iamnedtan/NSAS/systems/README.md

# Created systems

Accessories and sets built on NSAS, grouped by hobby or use. Each system has its own folder and README.

| System | Contents |
|---|---|
| [modelling-gunpla](modelling-gunpla/) | Tool holders for plastic model building: nipper holder, sanding block |
| [tools](tools/) | Everyday desk tools and supplies: mini coffee cup holder (Starbucks, Luckin) |
| [nabs](nabs/) | NABS, Ned Angle Base System: hinged base plates with NSAS sockets, slot-ins, joiners and an NSAS panel adapter. Own spec, draft v0.1 |

Planned: display garages built on NABS, and other systems.
