iamnedtan/NSAS/spec/NSAS Spec Sheet.html

Specification

# Ned Slotted Angle System

45° gravity-lock socket grid for FDM-printed panels and accessories

DocumentNSAS-SPEC

Revisionv0.13 draft

Date2026-10-21

Unitsmm, degrees

Viewsto scale, per view

ProcessFDM

## 壱What it is 概要

A pegboard-style mounting surface. A grid of 5 mm square sockets is cut into a panel. Every socket slopes 45° downward into the material. Accessories such as trays and tool holders carry matching holes, and a square key joins the accessory to a socket. The key is one straight bar, so the accessory hole lies on the same 45° line as the socket but, seen from the accessory's back face, it rises as it goes in (section 7).

The socket slopes down as it goes in, so the accessory's weight pushes the key deeper. The key cannot be pulled straight out. To remove it, lift and tilt. No clips or screws are needed.

An optional thin groove between socket rows hollows out the panel and stiffens it for FDM printing.

## 弐Orientation and terms 向きと用語

Term | Meaning
Face | Panel surface the accessories hang on. Used vertically.
Back face | Flat accessory surface that rests against the panel face. Accessory holes start here.
Perpendicular (⊥) | Measured at right angles to the face, into the panel. All depths are perpendicular.
Vertical | Measured up and down along the face.
Along the slope (∥) | Measured along the 45° socket axis. Equals perpendicular × √2.
Cross-section | Square sizes (socket 5.00, key 4.60 / 4.80 / 5.00 / 5.10) are measured across the 45° axis, at right angles to it.
C–C | Centre to centre. All pitches and hole spacings are C–C.
Face height | A 45° feature that is t thick across its walls shows t × √2 tall on the face. A 5.00 socket shows 7.07.

## 参Socket ソケット

View A. Section through one socket. Face on the left, hatched material, 1 mm skin at the back.

Item | Value
Cross-section | 5.00 × 5.00 square (across the axis)
Angle | 45° down into face
Face height | 7.07 (5 × √2)
Functional depth | 10.00 ⊥ (14.14 along slope)
Modelled depth | 11.00 ⊥ (15.56 along slope)
Floor | Flat, parallel to face
Mouth lead-in | 0.5 × 45° chamfer on side edges, 22.5° bevel on lip (not drawn)
Min. panel thickness | modelled depth + skin (11 + 1 = 12)

- Modelled depth = functional depth + 1 mm. The relief keeps the key off the floor.
- Surface too thin: add a local raised panel, or use a shallower face with a customised key (section 6).

## 肆Grid layout グリッド配置

The grid has no fixed size. Fit as many columns and rows as the area allows, then centre the grid so that opposite margins are equal. Rows are not staggered.

Tileable panels. When panels may be combined side by side or stacked, use a 2.50 margin left and right and a 5.732 margin top and bottom. Two margins then add up to exactly one wall (5.00) or one row gap (11.464), so the column pitch, row pitch and the 30 mm rule carry on across the joint. Panel size: n columns × 10.00 wide, r rows × 18.536 tall.

View B. Face view, example 5 columns × 3 rows with grooves. Sockets solid, grooves grey. m = equal margins.

View C. Section through three rows. Vertical dimensions on the face.

### Columns

Item | Value
Column pitch | 10.00
Wall between sockets | 5.00
Outer-wall span, n columns | (n − 1) × 10 + 5
Side margin, tileable | 2.50 (wall / 2)
Panel width, tileable | n × 10

### Rows: the 30 mm rule

Top wall of row k to bottom wall of row k + 2, measured vertically, is 30.000. With h = 7.071 face height:

Item | Formula | Value
Row pitch | (30 + h) / 2 | 18.536
Gap | (30 − h) / 2 | 11.464
Outer to outer, 2 rows | (30 + 3h) / 2 | 25.607
Row k → k + 2 | 2p − h | 30.000
Solid between tunnels ⊥ | p × sin 45° − 5 | 8.107
Top / bottom margin, tileable | gap / 2 = (30 − h) / 4 | 5.732
Panel height, tileable, r rows | r × p | r × 18.536

Stacked tileable panels: the row gap at the joint is split across the two panels, so it gets no groove.

## 伍Groove 溝 optional

- Purpose: hollows out material and increases strength for FDM printing. Less infill is needed, but the extra walls can make the print take longer.
- Include: ask if the groove is required.
- Skip: when the area is small and does not need it, for example a small accessory panel or a single row. Say that it was skipped.
- Wide top-edge groove (reference cover, optional): same purpose. It reinforces the panel for FDM printing and reduces infill, at the cost of a possibly longer print. Take its profile from the reference cover; it is not dimensioned here.

Item | Value | Notes
Position | One in every gap between rows | Views B and C
Vertical placement | Centred in the gap | 4.25 land above and below
Thickness | 2.10 ⊥ walls | 2.97 on the face
Angle | 45° down | Parallel to the sockets
Depth | 8.00 ⊥
Wall to each socket | 3.00 ⊥ walls | (8.107 − 2.10) / 2; constant along the groove
Material behind floor | 4.00 | On a 12 mm panel (12 − 8)
Length | Equal to the outer-wall span | (n − 1) × 10 + 5
Ends | Square, aligned with the outermost socket walls

## 陸Key キー

The key joins the accessory to the panel sockets. It is one straight 45° square bar with a thin stop plate across it. The bar fits snugly into the panel (not a press fit), so accessories can be moved and replaced quickly. It press-fits into the accessory, so it stays with the accessory when moved. The stop rests flat on the panel face and sets the insertion depth.

The two side faces are flat and flush along the whole key (4.60 apart), so it prints lying on one side. Both legs share one profile: a split peg whose upper and lower faces widen in a straight line from the root to a square tip, with a 1.00 slot along the axis that splits it into two prongs. Neither leg has a chamfer, lead-in or root relief (v0.13). Instead, every edge that runs across the key between the flat sides has a 0.50 round: the tips, slot mouths, slot ends and stop ends. The four inside corners where the stop meets the legs stay sharp, so the stop seats flat. The legs differ only in fit. The accessory leg is an expanding peg: it is 5.80 long, 0.20 short of the 6.00 hole floor, and widens from 4.80 at the root to an oversize 5.10 at the tip, so in the 5.00 hole the prongs squeeze together and spring back against the walls. The panel leg has a lighter fit: it widens from 4.60 to 5.00 (line-to-line), and its slot stops 3.00 from the panel face. The accessory slot runs back toward the stop until its end is 5.00 from the panel slot end, measured along the bar, so it ends 0.46 inside the stop (View D1). Neither leg has crush ribs (v0.11): both keep 0.20 side clearance per side.

View D. Key seated in a panel socket and an accessory wall. Key shaded; prongs drawn relaxed (before they squeeze to 5.00), slot between them. Square tips with the 0.50 edge rounds on the tips, slot mouths, slot ends and stop ends. The leg tip stops 0.20 short of the hole floor.

Item | Value | Fit
Panel leg, root | 4.60 × 4.60 | 0.20 / side clearance
Panel leg, tip | 5.00 × 4.60 | Snug, line-to-line; taper on upper and lower faces
Panel prong slot | 1.00 wide, to 3.00 ⊥ from panel face | Solid near the face for bending strength
Panel leg tip end | square | No chamfer; 0.50 edge rounds
Panel leg engagement | 10.00 ⊥ from panel face | Stop on face; 1.00 relief to floor
Side faces, whole key | 4.60 apart | Flat and flush; 0.20 / side clearance; print on either side
Accessory leg, root | 4.80 × 4.60 | 0.10 / side clearance in 5.00 hole
Accessory leg, tip (relaxed) | 5.10 × 4.60 | 0.05 / side interference, taken by the prongs; square tip, 0.50 edge rounds
Accessory leg taper | linear, 4.80 → 5.10 | Upper and lower faces only, widens to the tip; line-to-line at 3.87 ⊥ from the stop (2/3 of the length)
Prong slot | 1.00 wide; end 5.00 from the panel slot end, along the bar | Ends 0.46 ⊥ inside the stop; deepest point 0.39 ⊥ from the panel face (View D1). Through both side faces; keep wider than tip − hole
Accessory leg length | 5.80 ⊥ | From stop to tip; 0.20 tip gap to the 6.00 hole floor
Edge rounds | 0.50 | Every edge running between the flat sides: leg tips, slot mouths, slot ends (full round), stop ends. Not on the four stop-to-leg inside corners
Stop | 1.00 ⊥ × 4.60 × 12.00 | Vertical plate, flat on panel face; ends cut at 45°; 2.75 past the bar above and below
Accessory hole | 5.00 square, 6.00 ⊥, rising | Fit set by the key only; see section 7

View D1. The two prong slot ends at the stop. Both ends are full rounds (0.50 radius). Measured along the bar, from the end of one round to the end of the other, they are 5.00 apart (3.54 ⊥). The panel slot end does not move, so the accessory slot ends 0.46 ⊥ inside the 1.00 stop. The stop stays solid on the panel face and above and below the slot.

View E. Key sections (shaded) inside a 5.00 hole (dashed). Tapered faces top and bottom, flat sides left and right. All three sections are split: the accessory slot reaches past the leg root into the stop. No crush ribs; 0.20 side clearance per side.

- Shallow faces: shorten the panel leg to that face's functional depth. Keep the 1 mm relief.
- Print orientation: lie the key on either flat side. The slot walls are then vertical, and each prong flexes within its layers.
- Tuning: loose: raise the tip (5.10 → 5.20). Too hard to push in: lower the tip or widen the slot. Keep the slot wider than tip − hole, so the prongs never close up.
- Stop check: the accessory slot ends inside the stop, so the stop is thin at the slot end (0.39 at the deepest point). After a few insert-and-remove cycles, look for cracks there. If it cracks, increase the slot spacing or thicken the stop.
- Fit check: before a full accessory, print one key and a small block with one 5.00 hole. Adjust the tip size, then keep the values that work for your printer.
- Tip gap: keep the accessory leg 0.20 shorter than the hole depth. Zero gap fitted best in test, but then a hole printed slightly shallow stops the key before the stop seats.

### Variant: thick stop

For accessories that must stand farther off the panel face, for example to clear obstructions such as the lip of a cover design. The stop is 3.00 thick instead of 1.00. The extra 2.00 grows toward the panel side: everything from the stop's accessory face outward is the same as the standard key, and the panel leg still engages the full 10.00 from the panel face. The accessory back face therefore sits 3.00 from the panel face (1.00 on the standard key).

Item | Standard | Thick stop
Stop thickness ⊥ | 1.00 | 3.00
Stop width × height | 4.60 × 12.00 | 4.60 × 12.00 (unchanged)
Panel leg, accessory leg | 10.00, 5.80 | 10.00, 5.80 (unchanged)
Accessory slot end | 0.46 ⊥ inside the stop | 0.46 ⊥ inside the stop, from its accessory face
Slot ends apart, along the bar | 5.00 | 7.83 (5.54 ⊥)
Panel face to accessory back face | 1.00 | 3.00
Overall length ⊥, tip to tip | 16.80 | 18.80
Edge rounds | 0.50 | 0.50, same edges

- Model: keys/NSAS key - accessories thick. Same parameters as the standard key with stop_t = 3 mm. The accessory slot end is held at its standard place: prong_root uses the standard 1 mm stop, not stop_t.
- Accessories and panels are unchanged: same sockets, same 6.00 accessory holes. Only the stand-off grows.
- Stop check: not needed on this variant. The stop is solid for 2.39 ⊥ behind the slot end.

## 漆Accessory interface アクセサリー接続部

Holes go in the accessory's back face, the flat face that rests against the panel. The key's stop sits between the two faces.

Direction — common mistakeThe key is one straight bar. Its panel leg goes into the panel and down, so its accessory leg points out of the panel and up. The accessory hole follows that leg: from the back face it goes in and rises 45°, 1 mm up for every 1 mm in. Same 45° line as the socket, run the other way. Never copy the socket's "45° down into the face" onto the accessory: a downward hole cannot take a key that is already in the panel. See View D.

Gravity lock: the accessory is pressed onto the rising leg, and its weight pulls it down and back along the bar, toward the panel.

Item | Value | Notes
Cross-section | 5.00 × 5.00 square | 0.10 / side over the 4.80 key root; fit set by the key taper
Direction | 45° rising into the accessory | Same line as the socket, opposite sense
Face height | 7.07 | 5 × √2, on the back face
Depth | 6.00 ⊥ (8.49 along slope) | Accessory leg 5.80 + 0.20 tip gap
Floor | Flat, parallel to the back face | 6.00 higher than the mouth
Blind or through | Blind when the wall is thicker than depth + skin | Through only on a wall thinner than the depth; the leg still needs its full 5.80

### Placement

- Horizontal hole spacing, C–C: a multiple of 10.00. Reference tray: 2 holes, 40 apart.
- Vertical hole spacing, C–C: a multiple of 18.536.
- Width for side-by-side hanging: n columns wide = n × 10 − clearance. Suggested clearance 1.00 total, so a 2-column holder is 19.00 wide.
- Top margin: the floor ends one depth higher than the mouth. Top of the back face to top of the upper mouth ≥ depth + skin (6 + 2 = 8.00).
- Wall behind the floor: check cavities, slopes and fillets inside the accessory. Keep at least 2.00 skin.
- Check before finishing: from the back face, every hole goes in and up. A key already in a panel socket must slide straight into it.

## 捌Parameters パラメーター

Drive the model from these values. Derive counts, row pitch and groove length; do not enter them as fixed numbers. Keep full precision in CAD; round only the displayed values.

Parameter | Default | Drives
Functional depth | 10.0 | Key engagement, modelled depth
Relief | 1.0 | Modelled depth = functional + relief
Socket size | 5.0 | Socket section, face height, accessory hole
Column pitch | 10.0 | Column count, span
Row rule distance | 30.0 | Row pitch, gap, row count
Groove thickness / depth | 2.1 / 8.0 | Groove section
Key root / tip width | 4.8 / 5.1 | Accessory leg taper; tip oversize for the expanding fit
Prong slot width / slot spacing | 1.0 / 5.0 | Prong flex; slot spacing is the distance between the accessory and panel slot ends, along the bar. The accessory slot end follows from it.
Accessory leg tip gap | 0.2 | Accessory leg = hole depth − tip gap (5.8)
Edge round | 0.5 | Edges between the flat sides: tips, slot mouths, slot ends, stop ends
Panel leg tip width / slot root land | 5.0 / 3.0 | Panel snug fit; solid leg next to the panel face
Key stop thickness / height | 1.0 / 12.0 | Stop plate; sets key insertion depth
Accessory hole depth | 6.0 | Key accessory leg + tip gap; floor height above the mouth
Accessory top skin | 2.0 | Top margin = hole depth + skin
Accessory width clearance | 1.0 | Width = columns × 10 − clearance
Panel area or margins | per design | Counts and centring
Tileable margins, side / top and bottom | 2.5 / 5.732 | Panels combined side by side or stacked; 5.732 = (30 − h) / 4

## 玖Open points 未決事項

None at present. Earlier points closed in v0.13: wide top-edge groove purpose (section 5), grid margins for tileable panels (section 4).

## 拾Revisions 改訂履歴

Rev | Change
v0.1 | First draft from design intent and the reference top cover.
v0.2 | Groove made optional. Purpose: hollowing and FDM strength.
v0.3 | Key slips into the panel. Key customisable for shallow faces.
v0.4 | Accessory leg tapers 4.8 → 5.0 for a press fit.
v0.5 | Key shape fixed: one straight 45° bar with a 1 mm stop. Groove face height 2.97, land 4.25.
v0.6 | Added ∥ and C–C conventions, groove wall 3.00 and floor material 4.00, key engagement datum, fit check.
v0.7 | Accessory hole direction fixed: rises 45° into the accessory (was read as "same as the socket", i.e. downward). Added hole depth 6.00, floor, blind/through, top margin, wall skin, side-by-side width and a direction check. Back face term added.
v0.8 | Key side faces flat and flush along the whole key (4.60); taper on the upper and lower faces only.
v0.9 | Tapered press fit proved loose. Accessory leg is now an expanding peg: slot splits it into two prongs, tip oversize 5.30 (root 5.00), 0.60 tip lead-in, two crush ribs on one side face (0.15 crush). New parameters for slot, lead-in and ribs.
v0.10 | Panel leg: snug fit, widens 4.60 → 5.00, prong slot to 3.00 from the face, two crush ribs (0.05 crush) on the same side face, 1.00 chamfer on the upper tip edge. All crush ribs taper 0.15 lower toward the tip.
v0.11 | Stop height reduced, 15.0 → 12.00 (2.75 past the bar above and below). All crush ribs removed from both legs.
v0.12 | Accessory leg kept popping out. Taper 5.00 → 5.30 reduced to 4.90 → 5.10. Ø1.00 relief at the root on the upper and lower faces, tangent to the stop. Prong slot now ends 1.00 from the stop (was 0.50).

v0.13

Print-tested: fits very well. Accessory leg takes the panel leg profile: straight taper 4.80 → 5.10 (root was 4.90), square tip, root reliefs and tip lead-in removed. Accessory leg 5.00 → 5.80, 0.20 short of the 6.00 hole floor (was 1.00). Accessory prong slot made longer: its end is 5.00 from the panel slot end along the bar (was 7.07), so it ends 0.46 inside the stop. Panel tip chamfer removed. 0.50 round on every edge between the flat sides, except the stop-to-leg inside corners. Thick-stop variant (3.00 stop, grown toward the panel side) added. Tileable-panel margins 2.50 side, 5.732 top and bottom. Groove trade-off and wide top-edge groove purpose added. Open points closed.
