iamnedtan/NSAS/systems/nabs/spec/NABS Spec Sheet.html

Specification

# Ned Angle Base System

Hinged base plates with NSAS 45° sockets, for displays and storage. Builds on NSAS-SPEC v0.13.

DocumentNABS-SPEC

Revisionv0.1 draft

Date2026-10-23

Unitsmm, degrees

ReferencesNSAS-SPEC v0.13

ProcessFDM

## 壱What it is 概要

A modular base plate for displays and storage, first made for plastic models. Each base is a flat plate with two rows of 45° sockets in its top face. Slot-in parts (uprights, runner holders, adapters) stand in the sockets on plain square legs.

NABS takes the NSAS socket (5.00 square, 45°) and the NSAS pitches (10.00 columns, 18.536 rows) from the NSAS spec sheet, v0.13. It does not take the NSAS key: NABS slot-ins have plain legs (section 7).

- Hinge edges: both long edges carry interleaving fingers. Two bases pinned with a length of 1.75 mm filament lie flat side by side, or one folds up 90° to make a wall (vertical mode).
- Sides: the short edges have no fingers. Bases placed side to side are locked by a side joiner in the middle channel, and the socket rows carry on across the joint.
- NSAS panels: a stack angle adapter lets a base slot into an NSAS panel like an accessory.

Rules and as-modelled valuesValues with no mark are design rules. Values marked as modelled are read off the Fusion model and are not yet design rules. The drawings are cut from the Fusion export, to scale per view.

## 弐Orientation and terms 向きと用語

Term | Meaning
Floor mode | The base lies flat, top face (socket mouths) up. All values are given in floor mode.
Vertical mode | The base folded 90° about its hinge, standing as a wall.
Column | One 10.00 slice of the base along its length: one socket per row, one channel hole, one finger per hinge edge.
Length, L | Along the rows, side to side. L = n × 10.00 for n columns.
Across | At right angles to the rows, hinge edge to hinge edge. Given from body face A (0.000) toward edge B.
Sides | The two short edges, at the ends of the rows. No fingers.
Hinge edges | The two long edges, with fingers. Edge A: wide fingers (4.95). Edge B: narrow fingers (4.75). Every socket descends toward edge B.
Body face | The flat face of the plate at a hinge edge, from which the fingers stick out.
Height | From the bottom face (0.0).
⊥, ∥, cross-section, C–C | As NSAS: perpendicular to the face, along the 45° slope, across the 45° axis, centre to centre.

## 参Base plate ベースプレート

View A. Section across the base through one socket column (column 1, through an edge-A finger). Hatched material. The edge-B fingers lie between the edge-A fingers, so they are not in this cut.

Item | Value | Notes
Thickness | 10.0
Body across | 64.142 | body face A → body face B; 37.071 + 27.071
Overall across | 84.142 | fingers 10.0 past each body face
Length | n × 10.0 | n = columns, a parameter in the Fusion model
Reference model | n = 10, 100 × 84.142 × 10
Top edges | 1.0 × 45° | on the body faces; as modelled

- Columns are a parameter. Every feature that repeats per column (sockets, triangle marks, channel holes, hinge fingers) follows n. Top pockets and underside hollows split by the rule in section 5.

## 肆Sockets and rows ソケットと列

View B. Plan from above, n = 10, rows running left to right, edge A at the top. Socket mouths and channel holes solid, pockets and the middle channel grey, triangle marks outlined.

### Socket

Item | Value | Notes
Cross-section | 5.00 × 5.00 | as NSAS
Angle | 45°, descending toward edge B | as NSAS
Mouth across, on the top face | 7.071 | 5 × √2
Depth | through the 10.0 plate (14.14 ∥) | NSAS sockets are blind. NABS keeps them through: no floor to print, debris falls out.
Mouth lead-in | ≈ 0.7 × 45° on the side edges; 22.5° bevel, 1.0 wide, on the edge-B lip | as modelled; not drawn

### Columns

Item | Value | Notes
Column pitch | 10.00 | as NSAS
First socket centre from the side | 5.0 | side margin 2.50, the NSAS tileable margin: bases side to side keep the 10.00 pitch
Wall between sockets | 5.00

### Rows

Each base has two rows. They are NSAS rows k and k + 2: two row pitches apart, with no row between them.

Item | Value | Notes
Row 1 mouth, across | 10.000 → 17.071
Row 2 mouth, across | 47.071 → 54.142
Row pitch | 37.071 | 2 × 18.536, the NSAS row pitch
Between the mouths | 30.000 | 2 × 18.536 − 7.071: the original NSAS 30 mm rule (section 10)
Base pitch across, pinned flat | 74.142 | 2 × 37.071: rows carry on at 37.071 across the hinge

### Triangle marks

Item | Value | Notes
Shape | equilateral, 4.0 side, 0.6 deep | cut into the top face
Direction | points toward edge B | the way the sockets descend
Along | between every pair of adjacent sockets | n − 1 per row; design rule
Across | row 1: 4.000 → 7.464; row 2: 43.571 → 47.035 | as modelled

The marks show which way the sockets slope, and they are decoration.

## 伍Channel, pockets and hollows 中央溝と肉抜き

### Middle channel

Runs the full length between the two rows. It takes the side joiner, the stack angle adapter and the M3 screws.

Item | Value | Notes
Across | 33.071 → 41.071 (8.0 wide)
Floor | 5.0 thick | channel 5.0 deep
Top edges | 1.5 × 45° | from 8.5 to the top face
Holes | 8.0 × 5.0, through the floor | one per column, on the socket columns; 5.0 webs between

### Top pockets: split rule

One lightening pocket runs beside each row: on row 1 between the row and the channel, on row 2 between the row and body face B. Their walls follow the 45° slope; inner corners 1.0 round. Profile as modelled.

- Pockets per row = ⌈n / 5⌉: one pocket for up to 5 columns, a new pocket for each further 5 columns or part of 5.
- All pockets in a row are the same length, with a 4.0 rib between them and a 2.5 end margin at each side.
- Pocket length = (L − 5.0 − 4.0 × (k − 1)) / k, for k pockets.

Columns n | Pockets per row | Pocket length
4 | 1 | 35.0
7 | 2 | 30.5 (3.5 columns each)
10 | 2 | 45.5
12 | 3 | 35.67 (about 4 columns each)

### Underside hollows

Each row has a hollow open to the bottom face, on the edge-A side of the socket tunnel: 2.0 roof, 2.0 wall to the socket, parallel to the slope (View A). They split with the top pockets (2.0 rib at n = 10). Small 1 × 1 relief grooves run along the bottom face. All as modelled.

## 陸Hinge and sides ヒンジと側面

View C. Two bases pinned flat, plan cut at 7.5, above the pin. Pin hole dashed.

View C2. Section through an edge-A finger, with the Ø1.75 filament pin (shaded) in its Ø2.5 hole.

Item | Value | Notes
Finger length | 10.0 past the body face | both edges
Edge A fingers | 4.95 wide, at 0 → 4.95 in each column | from the side
Edge B fingers | 4.75 wide, at 5.15 → 9.90 in each column
Finger clearance | 0.20 and 0.25 | between interleaved fingers
Pin hole | Ø2.5, full length, 5.0 high | mid-thickness
Pin hole, across | mid-finger: 5.0 from the tip and from the body face | both edges; the holes line up when edge-A fingers of one base sit in the edge-B gaps of the next
Pin | 1.75 filament | 0.75 diametral clearance: turns freely
Finger chamfers | 1.0 × 45° | edge A: top and bottom tip edges; edge B: top tip edge; as modelled

- Flat: two bases pinned side by side, at a 74.142 base pitch. The rows continue across the hinge at 37.071.
- Folded (vertical mode): one base turned 90° about the pin stands as a wall, sockets facing inward (View D2). With side walls this makes the floor-and-wall corners of a display garage.
- Sides: flat, no fingers. Bases side to side keep the 10.00 column pitch (2.5 + 2.5 margins). A side joiner in the channel bridges the joint (View E).

## 漆Parts 部品

All slot-in legs are plain: no stop plate, split prongs or taper. The body of the part rests on the base's top face and sets the depth.

### Slot-in leg

Item | Value | Notes
Section | 4.6 × 4.6 | standard; 0.2 / side clearance in the 5.00 socket
Section, loose fit | 4.4 × 4.4 | 0.3 / side; tight printers or quicker swapping
Angle | 45°, centred in the socket
Depth | 9.5 ⊥ below the top face | ends 0.5 above the bottom face
Tip | flat, parallel to the top face
Spacing between rows | 37.071 | one leg per row

### Standard slot in

View D1. Standard slot in (shaded) seated in a base, section through column 2.

A template: the reference shape to build other slot-in parts from.

Item | Value
Body | 64.142 × 4.6 × 9.0 above the top face
Ends | flush with the body faces
Underside relief | 20.0 × 4.0, across 22.071 → 42.071 (as modelled)
Legs | 2, one per row, 4.6

### Runner slot in

View D2. Runner slot in (shaded) in a floor base and a wall base folded up on the hinge, section through column 1.

Holds a gunpla runner: lay the runner along the arm, then tape it or cable-tie it round the arm. With legs in a floor base and a wall base, it also holds the two bases at 90°.

Item | Value
Shape | L: floor arm + wall arm, each 73.642, 4.6 thick
Arm height | 8.0 at the edges, 6.7 at the groove
Runner groove | 90° V, ≈ 1.6 deep (as modelled)
Legs | 2 down, 2 sideways, 37.071 apart
Leg fit | 4.6 standard; 4.4 loose-fit variant

### Side joiner

View E. Side joiner (shaded) across the side joint of two bases, section along the middle channel.

Item | Value | Notes
Plug | 7.9 × 14.6 × 3.5 | on the channel floor, top 1.5 below the top face; 0.1 clearance across the channel
Legs | 2 × (7.9 × 4.6 × 5.0), 10.0 C–C | straight down into the channel holes, flush with the bottom
Use | last channel hole of one base + first hole of the next | locks bases side to side

### Stack angle adapter

View F. Stack angle adapter (shaded) hanging a base on an NSAS panel (panel schematic: 11.0 socket on a 1.0 skin). Panel face vertical, edge B down.

Lets a base slot into an NSAS panel like an accessory. The base's bottom face rests on the panel face with edge B down. Its own sockets then slope down into the base, so parts in them gravity-lock as on NSAS.

Item | Value
Plug | as the side joiner, 7.9 × 14.6; 2.0 × 45° on its lower edge-B edge
Legs | 2 × 4.6 square, 10.00 C–C (NSAS column pitch)
Leg below the base | 45°, toward edge B, 9.5 ⊥

### Base, M3 mount variant

Screws a base to a desk, shelf or board. The screw goes in from above, through the channel.

Item | Value | Notes
Pad | 15.0 long, full channel width, top at 7.0 | 2.0 above the channel floor; covers one channel hole
Hole | Ø3.0 through, Ø6.0 × 2.8 counterbore | from the pad top
Count and position | one per top pocket, centred on its length | design rule; n = 10: 2 holes, 25 from each side

## 捌Display garage ディスプレイガレージ roadmap

Not yet designed. Planned layouts, built from bases and slot-ins:

- Floor and back wall: a base with a second base folded up on its hinge.
- Side walls: more folded bases, giving a box-like garage.
- Stacked levels: garages on garages.
- Wall-hung: garages hung on an NSAS panel with stack angle adapters.

## 玖Files and open points ファイルと未決事項

File (parts/, .step and .stl) | Part
NABS base | Base, n = 10
NABS base - M3 mount | Base with M3 mount
NABS standard slot in | Standard slot in (template)
NABS runner slot in | Runner slot in, 4.6 legs
NABS runner slot in - loose fit | Runner slot in, 4.4 legs
NABS side joiner | Side joiner
NABS stack angle adapter | Stack angle adapter

The Fusion model is the source. The files were split from its export, one part each, moved so that the bounding box starts at the origin. Fusion's "base piece in vertical mode" is the base turned, so it has no file of its own.

### Open points

1. Print orientation and supports for each part.
2. Turn the as-modelled profiles (pockets, hollows, relief grooves, mouth lead-in) into design rules.

## 拾History and revisions 沿革と改訂履歴

- 2026-01-31, the first NSAS part. Ned was remodelling a plastic modelling trolley and wanted a quick way to reconfigure and move items around, like a pegboard. For it he designed this base in Fusion (file "angleslot system"): the first part to use the 45° socket, with the slot ins, joiner, adapter and M3 variant.
- The 30 mm rule. The base's two rows were set 30 mm apart between the mouths. This became the NSAS row rule. On NSAS wall panels 30 mm between rows proved too far, so two sets of rows were interleaved, giving the 18.536 row pitch. NABS keeps the original spacing: its rows are NSAS rows k and k + 2.
- NSAS grows from it. Later in the same project NSAS grew its own way: wall panels, the key with its stop and split-prong legs, blind sockets, grooves, tileable margins. The base kept its January form.
- 2026-10-23. Fusion model exported and split into parts; system named NABS; spec written.

Rev | Change
v0.1 | First draft, measured from the Fusion export with the designer's answers. Design rules: parametric column count, pocket split ⌈n/5⌉, triangle marks between adjacent sockets, one M3 hole per pocket, 4.6 standard leg, through sockets kept.
