iamnedtan/NSAS/systems/tools/ikea-uppdatera-variera-slot-in-holder/profile.png

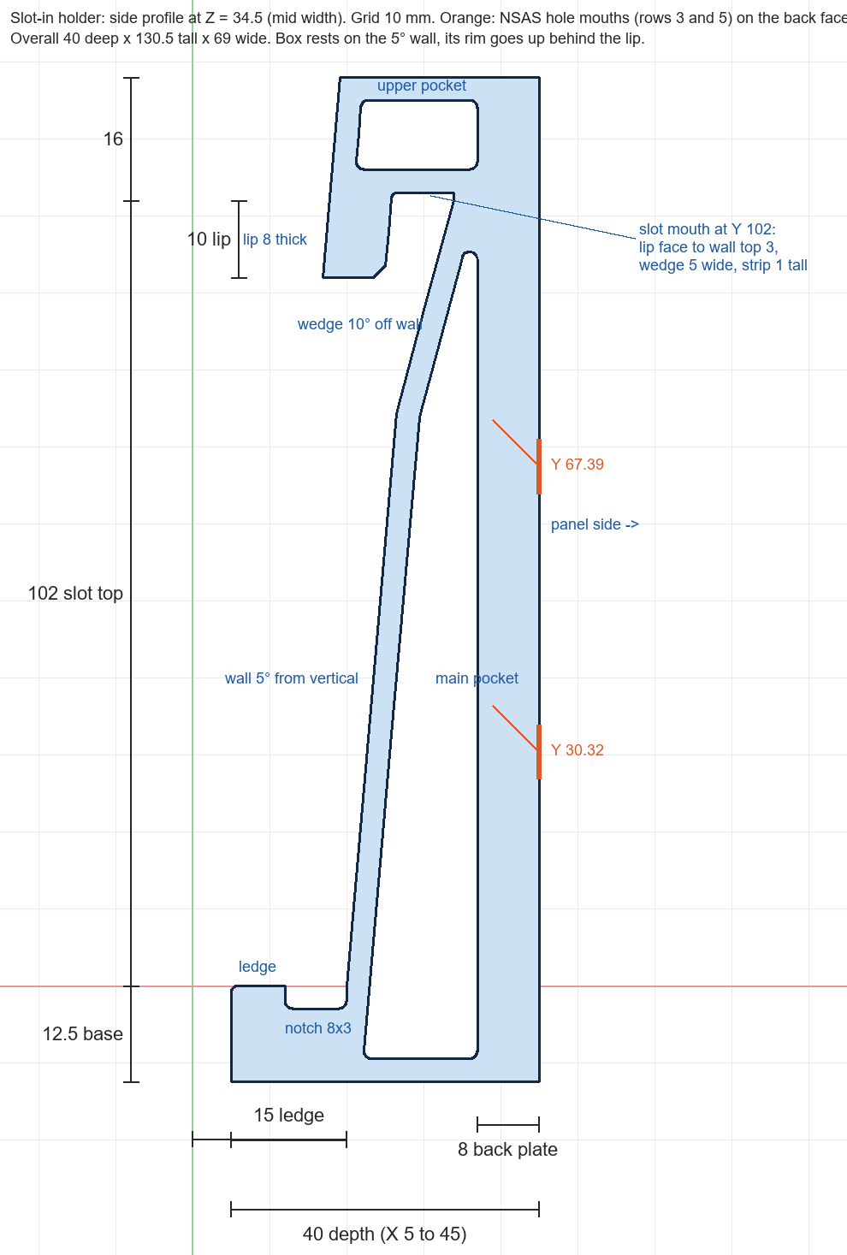
systems/tools/ikea-uppdatera-variera-slot-in-holder/profile.png
