iamnedtan/NSAS/systems/tools/ikea-uppdatera-variera-slot-in-holder/profile_offset.png

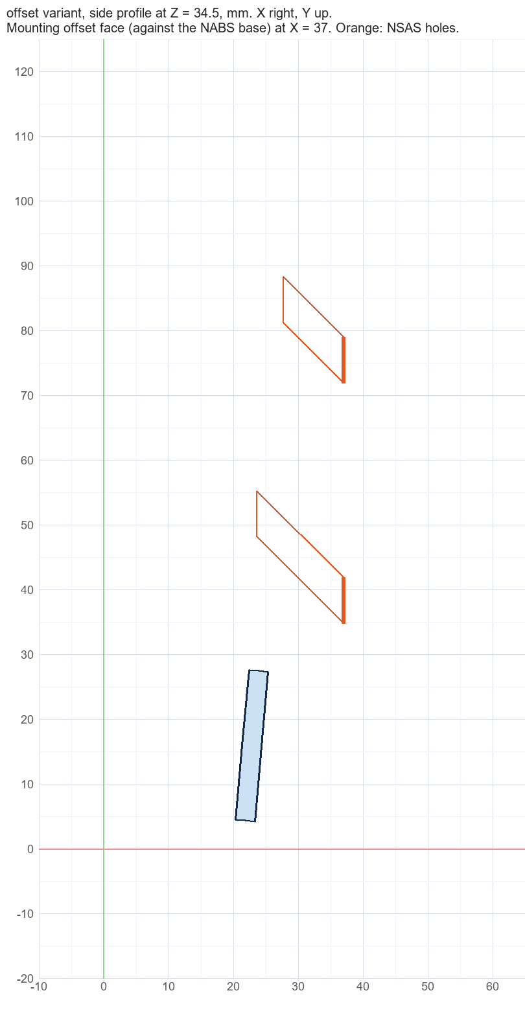
systems/tools/ikea-uppdatera-variera-slot-in-holder/profile_offset.png
