iamnedtan/NSAS/keys/key_fit_test/STL/plate_all.stl

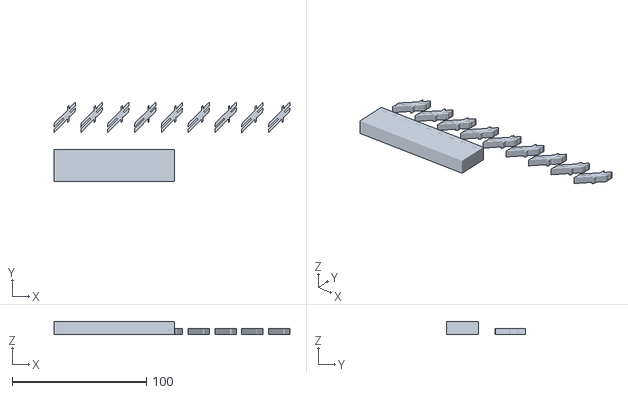
[picture p3: CAD file, 2026-10-20]
keys/key_fit_test/STL/plate_all.stl
176.0 x 59.2 x 10.0
