iamnedtan/NSAS/keys/NSAS key - accessories.step

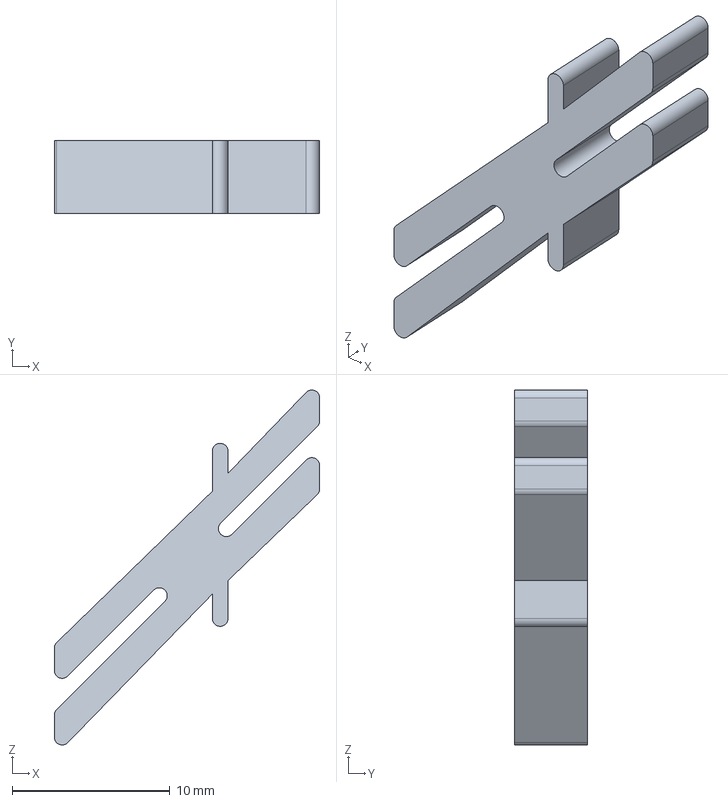
[picture p4: CAD file, 2026-10-21]
keys/NSAS key - accessories.step
16.8 x 4.60 x 22.5 mm
