iamnedtan/NSAS/systems/modelling-gunpla/nipper-holder/nipper holder - NSAS.step

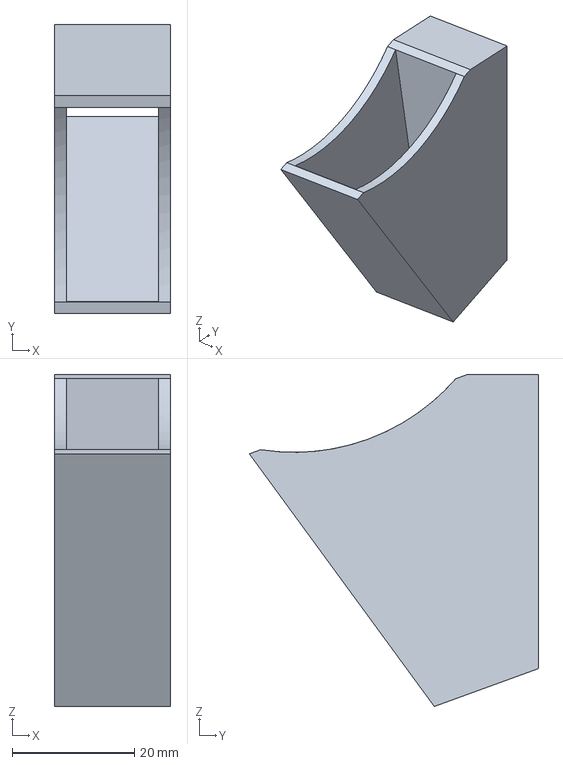
[picture p5: CAD file, 2026-10-21]
systems/modelling-gunpla/nipper-holder/nipper holder - NSAS.step
19.0 x 47.4 x 54.4 mm
