iamnedtan/NSAS/systems/modelling-gunpla/sanding-block/sanding_block.step

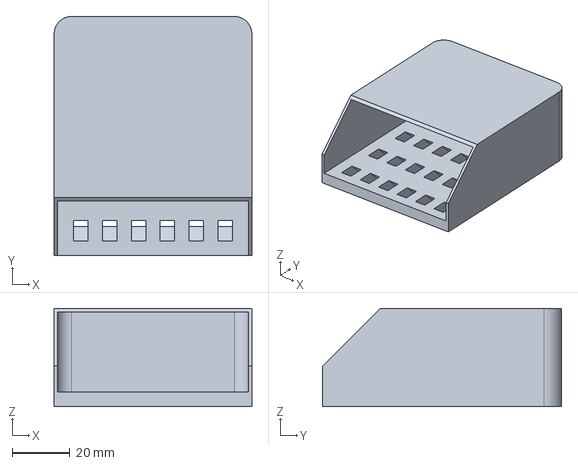
[picture p6: CAD file, 2026-10-21]
systems/modelling-gunpla/sanding-block/sanding_block.step
68.4 x 82.7 x 34.0 mm
