iamnedtan/NSAS/systems/nabs/parts/NABS base - M3 mount.step

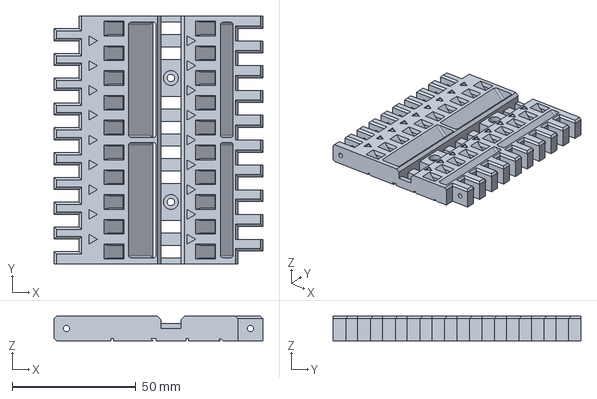
[picture p7: CAD file, 2026-10-23]
systems/nabs/parts/NABS base - M3 mount.step
84.1 x 100.0 x 10.00 mm
