iamnedtan/NSAS/systems/tools/ikea-uppdatera-variera-slot-in-holder/mockup/slot_in_holder_offset_on_NABS_base.step

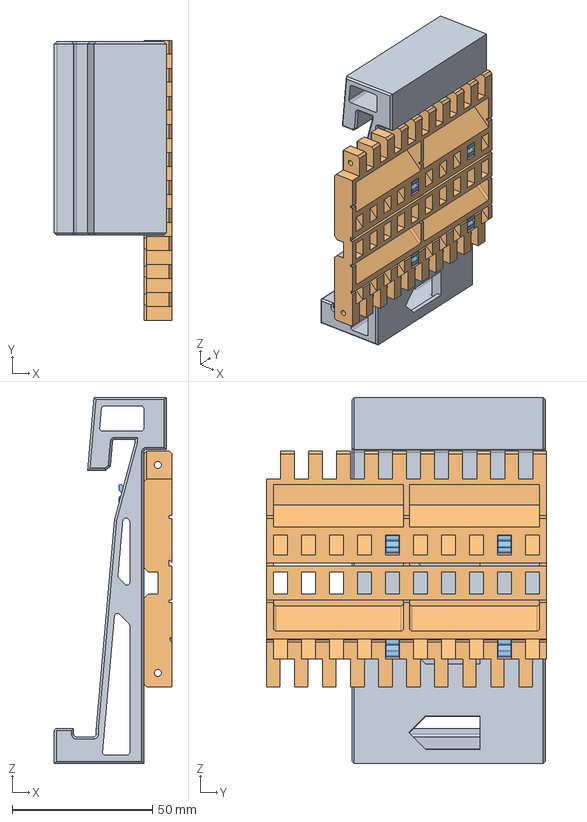
[picture p9: CAD file, 2026-10-23]
systems/tools/ikea-uppdatera-variera-slot-in-holder/mockup/slot_in_holder_offset_on_NABS_base.step
42.0 x 100.0 x 130.5 mm
slot_in_holder_offset
NABS_base
NSAS_key_4 x 4
