iamnedtan/NSAS/systems/tools/mini-coffee-cup-holder/cup_holder_luckin.step

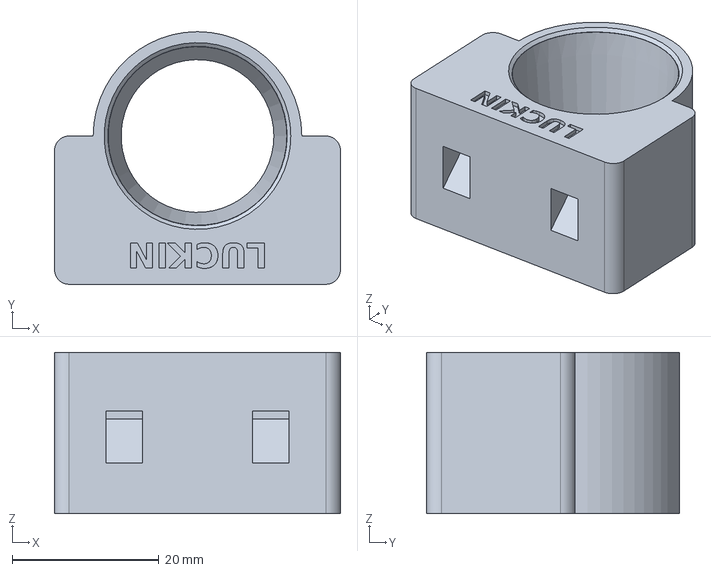
[picture p10: CAD file, 2026-10-21]
systems/tools/mini-coffee-cup-holder/cup_holder_luckin.step
39.0 x 34.5 x 22.0 mm
