iamnedtan/NSAS/systems/tools/mini-coffee-cup-holder/mockup/cup_holder_luckin_mockup_half.step

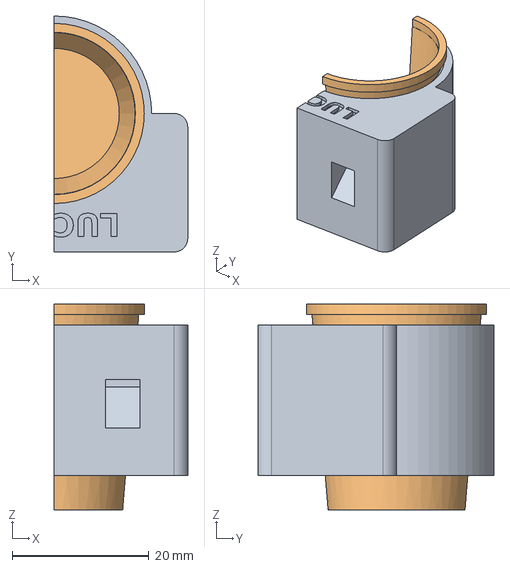
[picture p11: CAD file, 2026-10-21]
systems/tools/mini-coffee-cup-holder/mockup/cup_holder_luckin_mockup_half.step
19.5 x 34.5 x 30.0 mm
holder
luckin_cup
