iamnedtan/NSAS/keys/key_fit_test/STL/test_block.stl

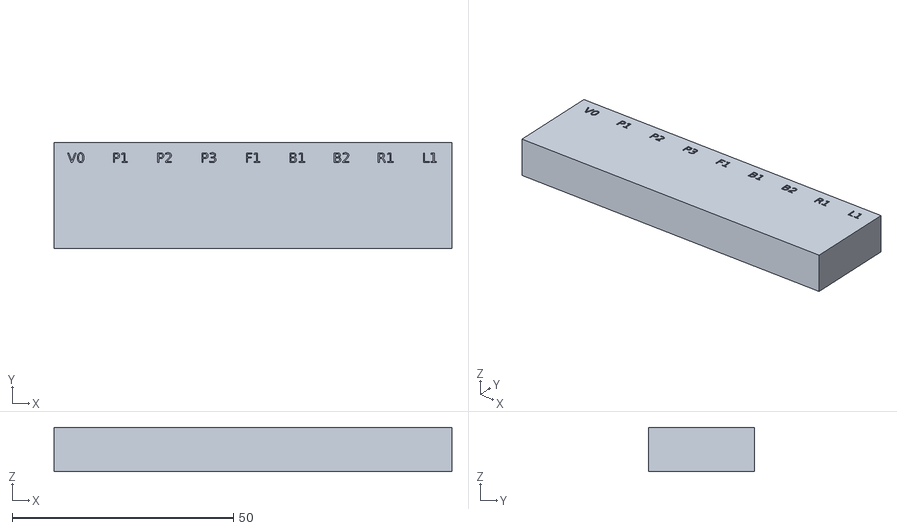
[picture p12: CAD file, 2026-10-20]
keys/key_fit_test/STL/test_block.stl
90.0 x 24.0 x 10.0
