iamnedtan/NSAS/keys/NSAS key - accessories thick.step

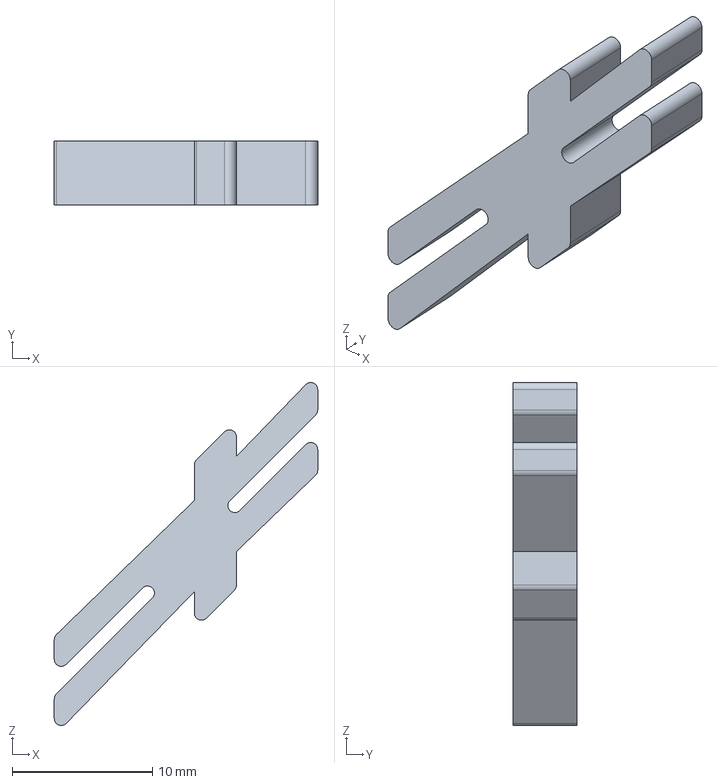
[picture p13: CAD file, 2026-10-21]
keys/NSAS key - accessories thick.step
18.8 x 4.60 x 24.5 mm
