iamnedtan/NSAS/systems/tools/ikea-uppdatera-variera-slot-in-holder/IKEA UPPDATERA and VARIERA - NSAS slot in holder - flat.step

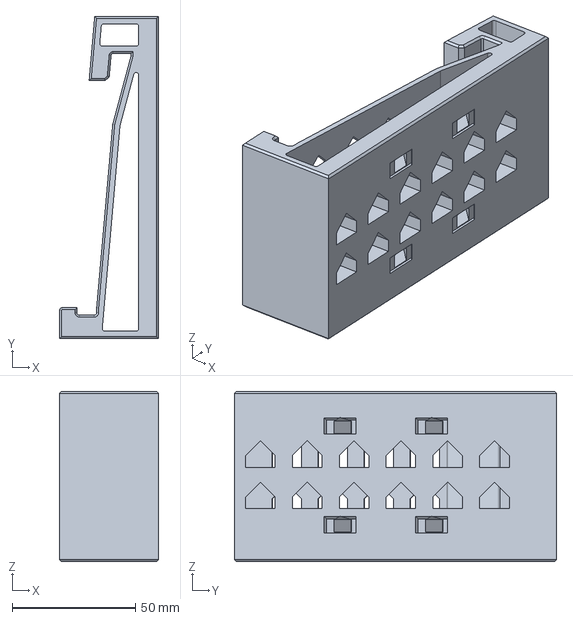
[picture p14: CAD file, 2026-10-23]
systems/tools/ikea-uppdatera-variera-slot-in-holder/IKEA UPPDATERA and VARIERA - NSAS slot in holder - flat.step
40.0 x 130.5 x 69.0 mm
