iamnedtan/NSAS/systems/tools/mini-coffee-cup-holder/cup_holder_starbucks.step

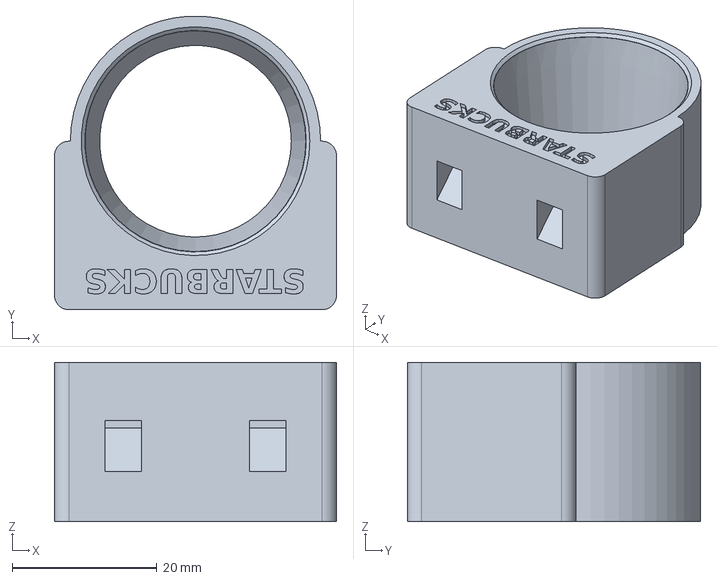
[picture p15: CAD file, 2026-10-21]
systems/tools/mini-coffee-cup-holder/cup_holder_starbucks.step
39.0 x 40.6 x 22.0 mm
