iamnedtan/NSAS/keys/key_fit_test/STL/plate_round_A.stl

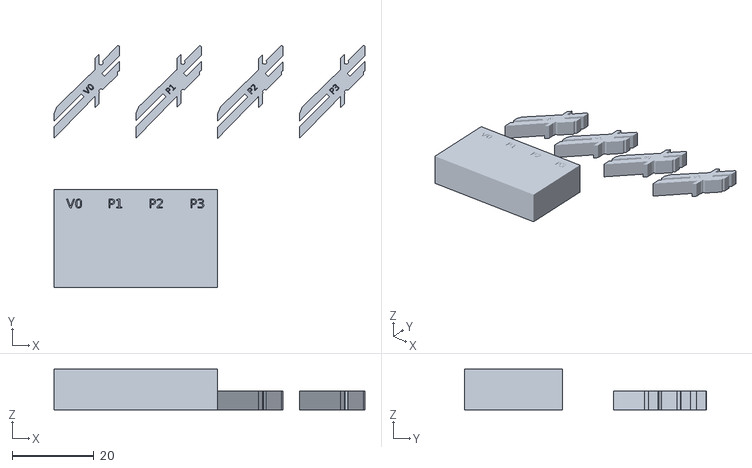
[picture p17: CAD file, 2026-10-20]
keys/key_fit_test/STL/plate_round_A.stl
76.0 x 59.2 x 10.0
