iamnedtan/NSAS/systems/nabs/parts/NABS runner slot in - loose fit.step

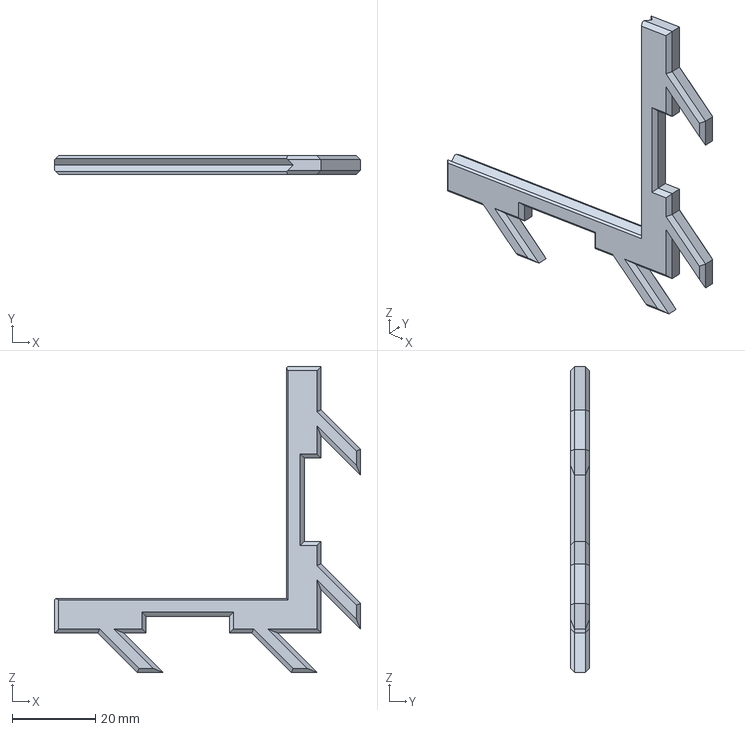
[picture p18: CAD file, 2026-10-23]
systems/nabs/parts/NABS runner slot in - loose fit.step
73.6 x 4.60 x 73.6 mm
