iamnedtan/NSAS/keys/key_fit_test/STL/plate_round_B.stl

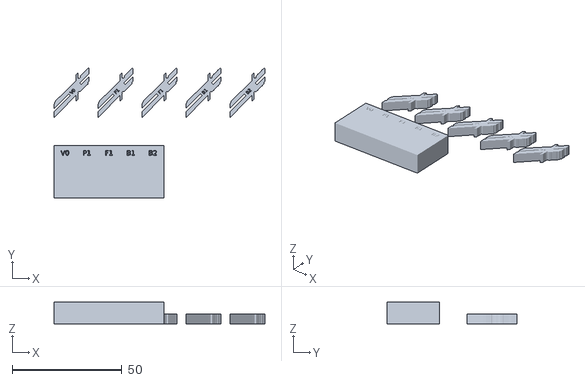
[picture p20: CAD file, 2026-10-20]
keys/key_fit_test/STL/plate_round_B.stl
96.0 x 59.2 x 10.0
