iamnedtan/NSAS/systems/tools/mini-coffee-cup-holder/mockup/cup_holder_starbucks_mockup_half.step

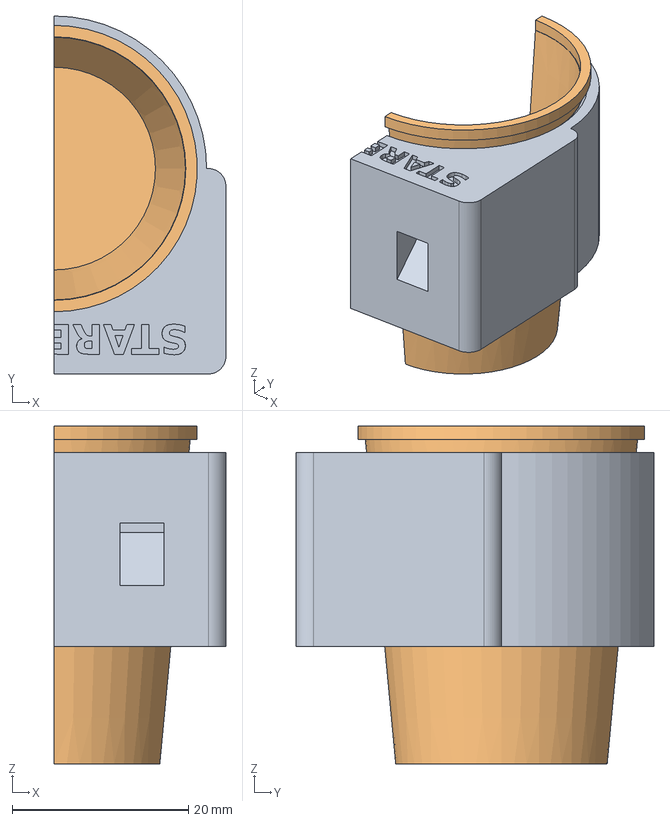
[picture p21: CAD file, 2026-10-21]
systems/tools/mini-coffee-cup-holder/mockup/cup_holder_starbucks_mockup_half.step
19.5 x 40.6 x 38.3 mm
holder
starbucks_cup
