iamnedtan/NSAS/systems/nabs/parts/NABS side joiner.step

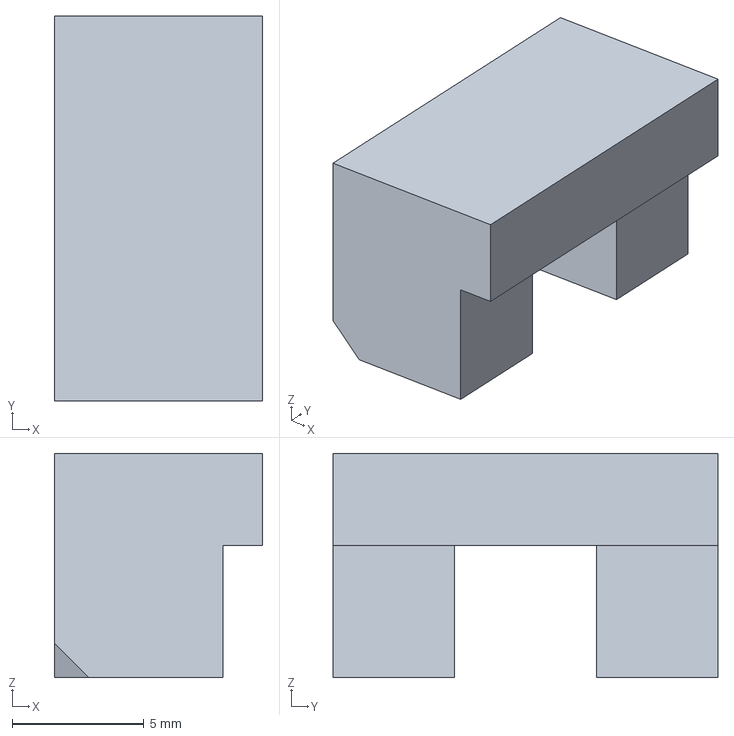
[picture p22: CAD file, 2026-10-23]
systems/nabs/parts/NABS side joiner.step
7.90 x 14.6 x 8.50 mm
