iamnedtan/NSAS/keys/key_fit_test/STL/key_B1.stl

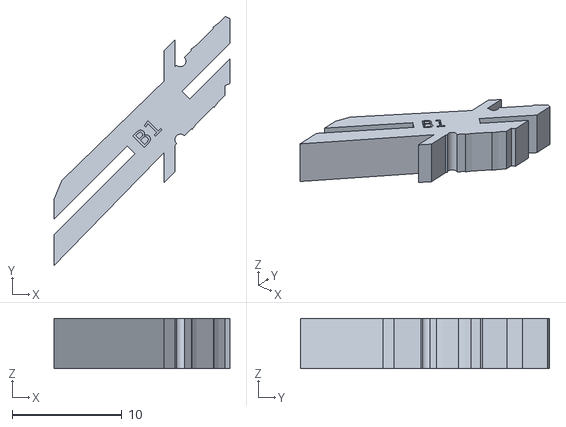
[picture p23: CAD file, 2026-10-20]
keys/key_fit_test/STL/key_B1.stl
16.0 x 22.7 x 4.60
