iamnedtan/NSAS/systems/nabs/parts/NABS standard slot in.step

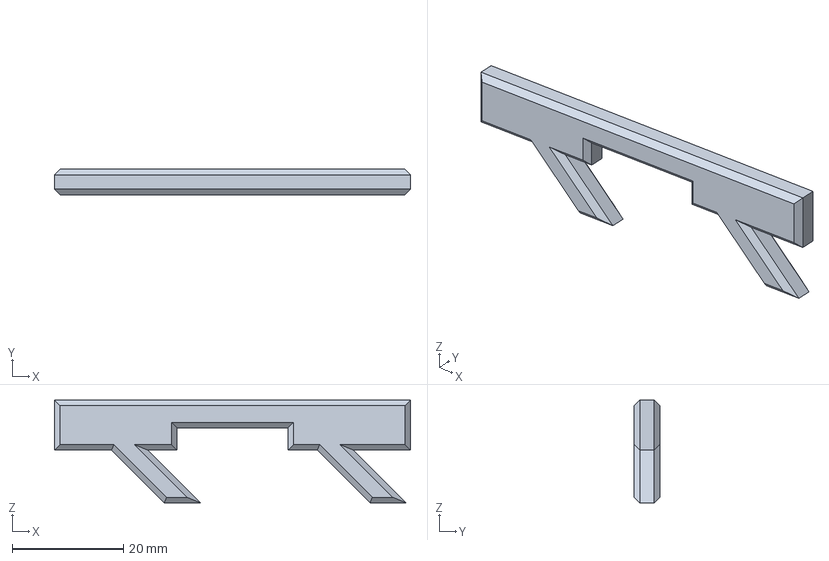
[picture p24: CAD file, 2026-10-23]
systems/nabs/parts/NABS standard slot in.step
64.1 x 4.60 x 18.5 mm
