iamnedtan/NSAS/keys/key_fit_test/STL/key_L1.stl

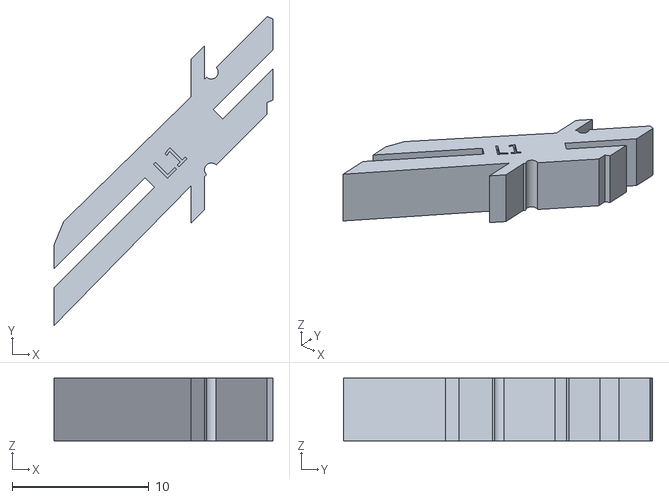
[picture p25: CAD file, 2026-10-20]
keys/key_fit_test/STL/key_L1.stl
16.0 x 22.6 x 4.60
