iamnedtan/NSAS/systems/nabs/parts/NABS stack angle adapter.step

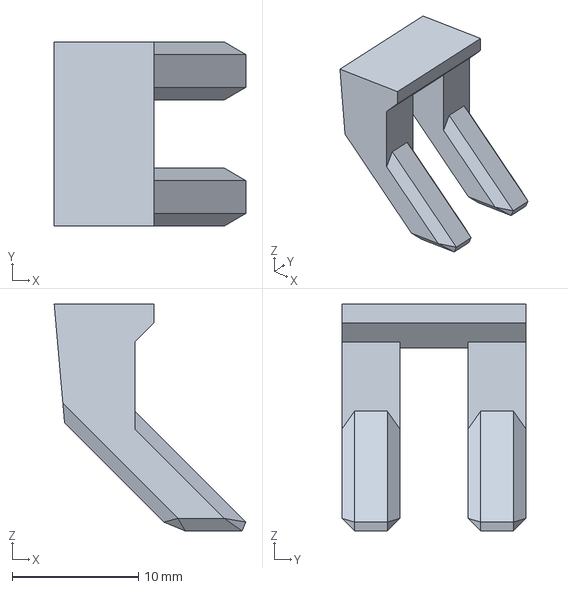
[picture p26: CAD file, 2026-10-23]
systems/nabs/parts/NABS stack angle adapter.step
15.2 x 14.6 x 18.0 mm
