iamnedtan/NSAS/(list of files, cad)

Other CAD files:
systems/nabs/parts/NABS base.step
systems/nabs/parts/NABS runner slot in.step
keys/key_fit_test/STL/plate_round_C.stl
keys/key_fit_test/STL/key_R1.stl
keys/key_fit_test/STL/key_B2.stl
keys/key_fit_test/STL/key_P1.stl
keys/key_fit_test/STL/key_P2.stl
keys/key_fit_test/STL/key_P3.stl
keys/key_fit_test/STL/key_V0.stl
keys/key_fit_test/STL/key_F1.stl
keys/NSAS key - accessories thick.stl
keys/NSAS key - accessories.stl
systems/modelling-gunpla/nipper-holder/nipper holder - NSAS.stl
systems/modelling-gunpla/sanding-block/sanding_block.stl
systems/nabs/parts/NABS base - M3 mount.stl
systems/nabs/parts/NABS base.stl
systems/nabs/parts/NABS runner slot in - loose fit.stl
systems/nabs/parts/NABS runner slot in.stl
systems/nabs/parts/NABS side joiner.stl
systems/nabs/parts/NABS stack angle adapter.stl
systems/nabs/parts/NABS standard slot in.stl
systems/tools/ikea-uppdatera-variera-slot-in-holder/IKEA UPPDATERA and VARIERA - NSAS slot in holder - flat.stl
systems/tools/ikea-uppdatera-variera-slot-in-holder/IKEA UPPDATERA and VARIERA - NSAS slot in holder - offset.stl
systems/tools/mini-coffee-cup-holder/cup_holder_luckin.stl
systems/tools/mini-coffee-cup-holder/cup_holder_starbucks.stl
