iamnedtan/NSAS/(commit log)

2026-10-20 Initial commit: RunnerCollector SolidCraft designs, exports and references
    [NSAS key - accessories.step]
2026-10-20 Add NSAS skill as project skill
    Copy of the Ned Slotted Angle System skill (SKILL.md, spec.md) so it
    loads automatically when this repo is opened on other machines.
2026-10-20 NSAS key: expanding split-prong accessory leg with crush ribs (spec v0.9)
    The tapered 4.8 -> 5.0 mm accessory leg was loose. The leg is now split by
    a 1.0 mm slot into two prongs that widen from 5.0 mm at the root to an
    oversize 5.3 mm at the tip, with a 0.6 mm tip lead-in. Two crush ribs on
    one flat side take up the side clearance (0.15 mm crush). Slot, ribs and
    lead-in are parameter-driven tilted boxes, so no feature depends on
    picked edges.
    Updates the md spec, the HTML spec sheet and the NSAS skill to v0.9, and
    re-exports the key STEP and STL.
    [NSAS key - accessories.step, NSAS key - accessories.stl]
2026-10-20 Remove duplicate NSAS spec; skill spec.md is the single text copy
    reference/slotted_system_spec.md had the same content as
    .claude/skills/nsas/spec.md. Point TODO.md and SKILL.md at the skill copy
    and the illustrated HTML sheet.
2026-10-20 NSAS key: snug split-prong panel leg, tapered ribs, panel tip chamfer (spec v0.10)
    The panel leg gets the same split-prong idea as the accessory leg, with a
    lighter fit so accessories stay easy to move: it widens from 4.6 mm at the
    root to 5.0 mm at the tip (line-to-line), a 1.0 mm slot runs from the tip
    to 3.0 mm from the panel face, and two crush ribs (0.05 mm crush) sit on
    the same flat side as the accessory ribs. A 1.0 mm chamfer on the upper
    tip edge helps the leg find the socket.
    All crush ribs now taper 0.15 mm lower toward their tip end. Ribs, slot
    and chamfer are parameter-driven tilted boxes, with no picked edges.
    Updates the skill spec, SKILL.md and the HTML spec sheet to v0.10,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
    [NSAS key - accessories.step, NSAS key - accessories.stl]
2026-10-20 NSAS key: 12 mm stop, remove crush ribs (spec v0.11)
    Stop plate height 15 -> 12 mm (2.75 mm past the bar above and below).
    Crush ribs removed from both legs; key is 4.6 mm across the flat sides
    with 0.2 mm side clearance per side. Key model rebuilt without the rib
    bodies and rib_* parameters; STEP and STL re-exported.
    [NSAS key - accessories.step, NSAS key - accessories.stl]
2026-10-20 NSAS key: 4.9 -> 5.1 accessory leg with root reliefs (spec v0.12)
    The accessory leg kept popping out of the hole. The taper on the
    upper and lower faces is reduced from 5.0 -> 5.3 mm to 4.9 -> 5.1 mm,
    and a 1.0 mm relief groove crosses each tapered face at the root.
    Each relief circle is tangent to the stop's accessory face with its
    centre on the leg edge, so the prongs flex from the root and the leg
    seats fully against the stop. The prong slot now ends 1.0 mm from
    the stop (was 0.5 mm) to keep the prongs thick enough at the relief.
    Key model: key_root 4.9, key_bulge 5.1, prong_root 1.0, new relief_d
    parameter driving two Y-axis cylinder cuts; STEP and STL re-exported.
    Spec sheet: View D re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
    [NSAS key - accessories.step, NSAS key - accessories.stl]
2026-10-20 NSAS key: add thick accessory key with 2.5 mm stop
    Copy of the accessory key with stop_t 1.0 -> 2.5 mm so the stop
    clears the lip of the RunnerCollector cover. Both legs are unchanged;
    the accessory leg, prong slot, lead-ins and root reliefs follow the
    stop face out by 1.5 mm. Out of spec, so the spec sheet is not updated.
    [NSAS key - accessories thick.step, NSAS key - accessories thick.stl]
2026-10-20 NSAS key fit test: accessory-leg variants, test block and print plates
    Parametric cadgen script for the v0.12 key with V0, P1-P3, F1, B1-B2,
    R1 and L1 accessory-leg variants, a 9-hole 45 deg test block and three
    test-round plates. Spec sheet unchanged until results are in.
    Claude-Session: https://claude.ai/code/session_01GKcSPqVCqheq8YpLKqboeD
    [key_B1.stl, key_B2.stl, key_F1.stl, key_L1.stl, key_P1.stl, key_P2.stl, key_P3.stl, key_R1.stl]
2026-10-20 NSAS key fit test: drop hang holes, shorten test block to 24 mm
    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
    [plate_all.stl, plate_round_A.stl, plate_round_B.stl, plate_round_C.stl, test_block.stl]
2026-10-21 NSAS key v0.13: panel-leg profile on the accessory leg, 0.2 mm tip gap
    Print-tested fit. The accessory leg now uses the panel leg profile:
    straight 4.8 -> 5.1 mm taper, square tip, no root reliefs or lead-in.
    Leg is 5.8 mm (6.0 hole depth minus a 0.2 mm tip gap). The prong slot
    runs back until it ends 5.0 mm from the panel slot end along the bar.
    Panel tip chamfer removed. 0.5 mm round on the edges between the flat
    sides, except the stop-to-leg inside corners.
    Spec sheet, spec.md and the NSAS skill summary updated to v0.13.
    [NSAS key - accessories.step, NSAS key - accessories.stl]
2026-10-21 NSAS v0.13: thick-stop key, tileable margins, spec sheet layout
    - Thick-stop key rebuilt on v0.13: 3 mm stop grown toward the panel
    side; accessory side and panel leg unchanged, 0.5 mm edge rounds.
    - Spec: thick-stop variant documented; tileable panel margins
    2.5 mm side and 5.732 mm top/bottom; groove trade-off and wide
    top-edge groove purpose; open points closed; RunnerCollector-specific
    notes removed.
    - Spec sheet: View D drawn with the 0.5 mm rounds, its table moved
    under the view, slot-end depth corrected to 0.39, Japanese section
    titles.
    [NSAS key - accessories thick.step, NSAS key - accessories thick.stl]
2026-10-21 Set up NSAS as its own repository
    - Point model and spec sheet paths at the new layout (keys/, spec/).
    - Replace the absolute RunnerCollector reference path with a repo link.
    - Add README, CC BY-SA 4.0 LICENSE and .gitattributes.
    [NSAS key - accessories thick.step, NSAS key - accessories.step]
2026-10-21 Add created systems: modelling/gunpla nipper holder and sanding block
    New systems/ section for accessory sets built on NSAS, one folder per
    hobby or use. First entry, systems/modelling-gunpla, holds copies of
    the nipper holder (RunnerCollector f9b0ef2) and the mini under-tray
    sanding block (RunnerCollector 193ac88). The originals stay in
    RunnerCollector.
    [mini_under_sanding_block.step, mini_under_sanding_block.stl, nipper holder - NSAS.step, nipper holder - NSAS.stl]
2026-10-21 Sanding block: standalone cadgen source
    Extract sanding_block_shape and the NSAS hole helper from RunnerCollector
    mini/src/mini_under_bins.py (193ac88) into src/sanding_block.py, with
    the mini box envelope replaced by fixed BLOCK_X/Y/H. The new export
    matches the copied STEP (same volume, area, bounding box, 112 faces,
    zero boolean difference) and replaces it as sanding_block.step/.stl.
    [mini_under_sanding_block.step, mini_under_sanding_block.stl, sanding_block.step, sanding_block.stl]
2026-10-21 README in the spec sheet style, linked to the live spec sheet
    - assets/readme/build.py renders the spec sheet's title block, section
    number badges, footer and three drawings (key, grid, socket) as SVG,
    with the sheet's drawing styles inlined, since GitHub strips CSS.
    - README uses them, mirrors the sheet's numbered sections with
    Japanese titles, and links to the spec sheet on GitHub Pages.
2026-10-21 Add tools system with Starbucks coffee cup holder
    - systems/tools/: new created system for everyday desk tools.
    - coffee-cup-holder: open NSAS ring for a mini freeze-dried coffee cup.
    The bore follows the cup taper (30.9 / 24.0 mm, 37.0 mm slant) over
    22 mm, so the cup wedges in with its lower part hanging below and a
    1.5 mm gap under the lip. Back plate with 2 NSAS accessory holes and
    STARBUCKS engraved in the top face. Source src/cup_holder.py, with
    variants in VARIANTS (Luckin to follow).
    - mockup/: holder with the cup seated, whole and in half, for checking.
    - README tables link the new system.
    [cup_holder_starbucks.step, cup_holder_starbucks.stl, cup_holder_starbucks_mockup.step, cup_holder_starbucks_mockup_half.step]
2026-10-21 Coffee cup holder: add Luckin variant
    - luckin: cup 29.7 / 20.0 mm, 28.6 mm slant (28.19 mm tall). Bore
    21.61 / 29.18 mm, cup hangs 4.7 mm below the ring, 1.5 mm lip gap,
    LUCKIN engraved on top.
    - Label now fits both a 30 mm width and a 3.5 mm height, so short
    names stay within the top face. Starbucks output is unchanged.
    - Mockup script builds every variant; Luckin mockups added.
    - READMEs list the Luckin variant and each cup's height.
    [cup_holder_luckin.step, cup_holder_luckin.stl, cup_holder_luckin_mockup.step, cup_holder_luckin_mockup_half.step]
2026-10-21 Coffee cup holder: correct Luckin top diameter to 24.7 mm
    The Luckin cup measures 24.7 mm below the lip, not 29.7. Cup height is
    now 28.50 mm and the taper 4.7 deg. Bore 20.83 / 24.45 mm, cup hangs
    5.0 mm below the ring, holder 39 x 34.5 x 22 mm, same 1.5 mm lip gap.
    Holder, mockups, README table and FIT note updated.
    [cup_holder_luckin.step, cup_holder_luckin.stl, cup_holder_luckin_mockup.step, cup_holder_luckin_mockup_half.step]
2026-10-21 Rename coffee-cup-holder to mini-coffee-cup-holder
    The holders are for mini instant-coffee cups, not drinking cups. Move
    systems/tools/coffee-cup-holder to systems/tools/mini-coffee-cup-holder
    and call it "mini coffee cup holder" in the READMEs and the source
    docstring. File names and geometry are unchanged; a rebuild from the
    new folder gives identical STEP and STL files.
    [cup_holder_luckin.step, cup_holder_luckin.stl, cup_holder_luckin_mockup.step, cup_holder_luckin_mockup_half.step, cup_holder_starbucks.step, cup_holder_starbucks.stl, cup_holder_starbucks_mockup.step, cup_holder_starbucks_mockup_half.step]
2026-10-23 Add IKEA UPPDATERA and VARIERA NSAS slot in holder
    Side profile replicated from the Fusion sketch and extruded 70 mm in
    cadgen. The base notch, top strip and wedge behind the wall are cut
    through as notches. Back face and top height are not dimensioned in
    the sketch and are estimates (RIGHT_X, TOP_Y).
    [IKEA UPPDATERA and VARIERA - NSAS slot in holder.step, IKEA UPPDATERA and VARIERA - NSAS slot in holder.stl]
2026-10-23 Add session hooks for cadgen and the CAD Viewer
    SessionStart keeps a cadgen 0.7.25 venv in the user profile, stops stray
    cadgen processes, and starts or reuses the CAD Viewer on port 3245.
    SessionEnd closes the viewer, except after /clear.
2026-10-23 Slot in holder: optimise and add NSAS accessory holes
    Pocket the body (about 31 % less material), fillet inner corners, add
    lead-ins at the lip and ledge, and set the width to 69 mm (7 x 10 - 1).
    The back face mounts on the panel with 8 accessory holes: 2 columns
    40 mm apart, 4 rows on every second row pitch so the holder fits
    current panels and older plates. Each hole has a 30 deg gable over its
    bridge for ABS printed profile-down. The base grows to 10.5 mm to keep
    2 mm under the bottom row.
    [IKEA UPPDATERA and VARIERA - NSAS slot in holder.step, IKEA UPPDATERA and VARIERA - NSAS slot in holder.stl]
2026-10-23 Slot in holder: through NSAS holes and windows to save material
    Back plate 8 mm with the accessory holes cut 8 mm through into the
    pockets, 7 rows on every row pitch (rows 1, 3, 5, 7 also fit older
    plates). Rows move down 2 mm for the top skin; base grows to 12.5 mm.
    Pointed-top windows through the back plate and the leaning wall into
    the main pocket, two per column along Z with a 6 mm band between them
    for stiffness in the profile plane. No bridges when printed
    profile-down. About 48 % less material than the solid profile.
    [IKEA UPPDATERA and VARIERA - NSAS slot in holder.step, IKEA UPPDATERA and VARIERA - NSAS slot in holder.stl]
2026-10-23 Slot in holder: chamfer the outline of both profile faces
    0.8 mm 45 deg chamfer round both end outlines, the bottom and top as
    printed, against elephant's foot. Under 1 mm to fit the strip at the
    slot mouth. The wedge-tip fillet is dropped: it was a 170 deg corner
    and blocked the chamfer.
    [IKEA UPPDATERA and VARIERA - NSAS slot in holder.step, IKEA UPPDATERA and VARIERA - NSAS slot in holder.stl]
2026-10-23 Add NABS, Ned Angle Base System
    The base plate from 2026-01-31, the first NSAS part (trolley remodel),
    becomes its own system under systems/nabs: text spec and illustrated
    spec sheet (draft v0.1, referencing NSAS v0.13), README with history,
    and one STEP and STL per part split from the Fusion export. The sheet's
    views are cut from the Fusion model by spec/src/build_sheet.py.
    [NABS base - M3 mount.step, NABS base - M3 mount.stl, NABS base.step, NABS base.stl, NABS runner slot in - loose fit.step, NABS runner slot in - loose fit.stl, NABS runner slot in.step, NABS runner slot in.stl]
2026-10-23 Slot in holder: flat and offset variants, NABS base mockup
    Holes cut to rows 3 and 5 only (37.07 mm apart, fits current and older
    plates). The design so far is saved as the flat variant; files gain
    " - flat".
    New offset variant to hang on a NABS base standing vertical, with
    thick-stop NSAS keys: main pocket filled, holes run through the wall
    into the slot and stop clear of the lip, an 8 mm cut from the back up
    to the overhang, which sits 0.5 mm over the base top. 3 mm recesses
    shaped like the thick stop (+0.5 mm) let the holder sit flush on the
    base.
    Mockup of the offset variant on a 10-column NABS base with four keys,
    and side-profile images of both variants.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
    [IKEA UPPDATERA and VARIERA - NSAS slot in holder - flat.step, IKEA UPPDATERA and VARIERA - NSAS slot in holder - flat.stl, IKEA UPPDATERA and VARIERA - NSAS slot in holder - offset.step, IKEA UPPDATERA and VARIERA - NSAS slot in holder - offset.stl, IKEA UPPDATERA and VARIERA - NSAS slot in holder.step, IKEA UPPDATERA and VARIERA - NSAS slot in holder.stl, slot_in_holder_offset_on_NABS_base.step]
2026-10-23 Slot in holder: hollow the offset variant
    Two through-width pockets split round the hole tunnels, keeping 2 mm
    walls round each tunnel and behind the stop recesses. Pointed-top
    windows into them through the offset face and the leaning wall,
    between the hole columns. The stop recess roofs slope at 45 deg so
    they print without a flat overhang. 133.1 to 95.1 cm3.
    [IKEA UPPDATERA and VARIERA - NSAS slot in holder - offset.step, IKEA UPPDATERA and VARIERA - NSAS slot in holder - offset.stl, slot_in_holder_offset_on_NABS_base.step]
2026-10-23 Slot in holder: stop recesses on the flat variant
    1 mm recesses in the back face round each hole mouth for the standard
    key's stop plate (+0.5 mm, 45 deg roof), so the flat variant sits
    flush on the panel. The recess code is shared with the offset variant,
    which keeps its 3 mm recesses for the thick-stop key.
    [IKEA UPPDATERA and VARIERA - NSAS slot in holder - flat.step, IKEA UPPDATERA and VARIERA - NSAS slot in holder - flat.stl]
2026-10-23 Slot in holder: core out the offset variant between the hole columns
    The band between the hole columns has no holes or recesses, so it is
    cored out from 3 mm behind the leaning wall to 2 mm under the offset
    face, with a 45 deg roof taper so only a short bridge is left. The
    windows open into it. 95.1 to 88.7 cm3. README explains why the offset
    variant has less room to hollow than the flat one.
    [IKEA UPPDATERA and VARIERA - NSAS slot in holder - offset.step, IKEA UPPDATERA and VARIERA - NSAS slot in holder - offset.stl, slot_in_holder_offset_on_NABS_base.step]
